maheen-ahmed1/OptoTACH/simulation/sweep_report.html

# Tachometer counting chain — 1 to 100 Hz sweep

Behavioural simulation of the circuit as built: 1.000 s gate from the 32.768 kHz chain, ÷60 burst multiplier, NE555 burst clock at 4800 Hz (R8 1k, R9 1k, C3 100nF). 12 input phases × 6 gate windows at every frequency.

Usable ceiling

4800 RPM

Quantisation

±60 RPM

Above ceiling

reads half

Timebase error

<0.005%

## What the display shows vs. actual speed

Dashed grey is a perfect instrument. Below 4800 RPM both traces sit on it.

As built — C3 = 100 nF C3 = 22 nF ideal instrument

The failure is silent. Past about 4900 RPM every second revolution arrives while the previous 12.5 ms burst is still running, so the latch ignores it. Exactly half the revolutions are dropped and the display settles on a steady, confident half reading — 6000 RPM shows as 3000. Nothing flickers or blanks to warn you.

## Worst-case error

At low speed both are limited by the same ±1 revolution quantisation; only the behaviour at the ceiling differs.

As built C3 = 22 nF

Data table

Input Hz | True RPM | Reads (as built) | Reads (22 nF) | Revs lost
1 | 60 | 60–60 | 60–60 | 0%
2 | 120 | 120–120 | 120–120 | 0%
5 | 300 | 300–300 | 300–300 | 0%
10 | 600 | 600–600 | 600–600 | 0%
20 | 1,200 | 1,200–1,200 | 1,200–1,200 | 0%
30 | 1,800 | 1,800–1,800 | 1,800–1,800 | 0%
40 | 2,400 | 2,400–2,400 | 2,400–2,400 | 0%
50 | 3,000 | 3,000–3,000 | 3,000–3,000 | 0%
60 | 3,600 | 3,600–3,600 | 3,600–3,600 | 0%
70 | 4,200 | 4,200–4,200 | 4,200–4,200 | 0%
75 | 4,500 | 4,500–4,500 | 4,500–4,500 | 0%
78 | 4,680 | 4,680–4,680 | 4,680–4,680 | 0%
80 | 4,800 | 3,840–4,800 | 4,800–4,800 | 6%
82 | 4,920 | 2,460–2,460 | 4,920–4,920 | 50%
85 | 5,100 | 2,524–2,576 | 5,100–5,100 | 50%
90 | 5,400 | 2,700–2,700 | 5,400–5,400 | 50%
95 | 5,700 | 2,830–2,870 | 5,700–5,700 | 50%
100 | 6,000 | 3,000–3,000 | 6,000–6,000 | 50%
