maheen-ahmed1/OptoTACH/media/optotach_display_powered.jpeg

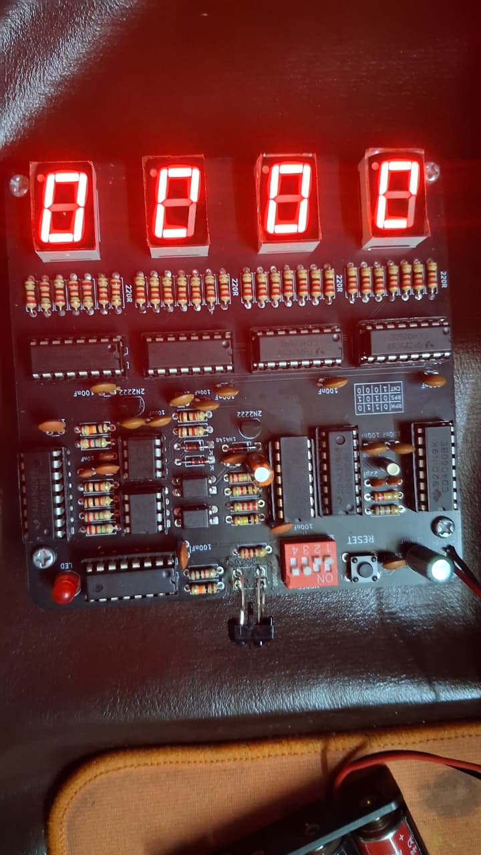
media/optotach_display_powered.jpeg
