maheen-ahmed1/OptoTACH/fabrication/BOM_OptoTACH_v1.0.csv

Refs | Value | Fit | Footprint | Qty | Source | Store | Notes
C1,C2,C7,C9,C12-C22 | 100nF | 100nF | Capacitor_THT:C_Disc_D3.0mm_W1.6mm_P2.50mm | 15 | Buy | RoboticsBD
C3 | 100nF | 100nF | Capacitor_THT:C_Disc_D3.0mm_W1.6mm_P2.50mm | 1 | Buy | RoboticsBD | NE555 (U6) burst oscillator - see alternate row below
C4,C5 | 22pF | 22pF | Capacitor_THT:C_Disc_D3.0mm_W1.6mm_P2.50mm | 2 | Buy | RoboticsBD
C6 | 1uF | 1uF | Capacitor_THT:C_Disc_D3.0mm_W1.6mm_P2.50mm | 1 | Buy | RoboticsBD | Ceramic, NOT electrolytic - this one sees both polarities
C8 | 100uF | 100uF | Capacitor_THT:CP_Radial_D6.3mm_P2.50mm | 1 | In stock
C10,C11 | 10nF | 10nF | Capacitor_THT:C_Disc_D3.0mm_W1.6mm_P2.50mm | 2 | Buy | Robotech, Techshop
D1-D3 | 1N4148 | 1N4148 | Diode_THT:D_DO-35_SOD27_P7.62mm_Horizontal | 3 | Buy | RoboticsBD
D4 | LED | LED | LED_THT:LED_D5.0mm | 1 | In stock
DS1-DS4 | 7SEG_CC_0.56in | 7SEG_CC_0.56in | Display_7Segment:7SegmentLED_LTS6760_LTS6780 | 4 | In stock |  | COMMON CATHODE. A common-anode part will not light at all.
J1 | PWR 5-6V | PWR 5-6V | Connector_PinHeader_2.54mm:PinHeader_1x02_P2.54mm_Vertical | 1 | Not fitted |  | Not fitted - power leads soldered straight into the J1 holes
Q1,Q2 | 2N2222 | 2N2222 | Package_TO_SOT_THT:TO-92_Inline | 2 | Buy | RoboticsBD | TO-92 plastic, not the TO-18 metal can
R1 | 200 | 220 | Resistor_THT:R_Axial_DIN0207_L6.3mm_D2.5mm_P7.62mm_Horizontal | 1 | Buy | Any shop | Drawn as 200, fit 220 - TCRT5000 IR LED current: 21.6 mA instead of 23.8 mA at 6 V
R2,R17 | 10K | 10K | Resistor_THT:R_Axial_DIN0207_L6.3mm_D2.5mm_P7.62mm_Horizontal | 2 | In stock
R3,R4,R7-R9,R14 | 1K | 1K | Resistor_THT:R_Axial_DIN0207_L6.3mm_D2.5mm_P7.62mm_Horizontal | 6 | In stock
R5,R6 | 2.2M | 2.2M | Resistor_THT:R_Axial_DIN0207_L6.3mm_D2.5mm_P7.62mm_Horizontal | 2 | In stock |  | Replaces the original design's 2M (not a stocked value)
R10 | 6.8K | 5.6K | Resistor_THT:R_Axial_DIN0207_L6.3mm_D2.5mm_P7.62mm_Horizontal | 1 | In stock |  | Drawn as 6.8K, fit 5.6K from stock - Q2 base resistor, only needs to saturate the transistor
R11 | 10M | 10M | Resistor_THT:R_Axial_DIN0207_L6.3mm_D2.5mm_P7.62mm_Horizontal | 1 | In stock
R12 | 220K | 220K | Resistor_THT:R_Axial_DIN0207_L6.3mm_D2.5mm_P7.62mm_Horizontal | 1 | In stock
R13 | 100K | 100K | Resistor_THT:R_Axial_DIN0207_L6.3mm_D2.5mm_P7.62mm_Horizontal | 1 | In stock
R15 | 2K | 2.2K | Resistor_THT:R_Axial_DIN0207_L6.3mm_D2.5mm_P7.62mm_Horizontal | 1 | In stock |  | Drawn as 2K, fit 2.2K from stock - Q1 base resistor, only needs to saturate the transistor
R16 | 20K | 22K | Resistor_THT:R_Axial_DIN0207_L6.3mm_D2.5mm_P7.62mm_Horizontal | 1 | In stock |  | Drawn as 20K, fit 22K from stock - Pulldown on the counter clock line, value not critical
R20-R26,R30-R36,R40-R46,R50-R56 | 220 | 220 | Resistor_THT:R_Axial_DIN0207_L6.3mm_D2.5mm_P7.62mm_Horizontal | 28 | Buy | Any shop | Segment resistors, 4 digits x 7
SW1 | MODE | MODE | Button_Switch_THT:SW_DIP_SPSTx04_Slide_9.78x12.34mm_W7.62mm_P2.54mm | 1 | Buy | RoboticsBD
SW2 | RESET | RESET | Button_Switch_THT:SW_PUSH_6mm | 1 | In stock
U1 | TCRT5000 | TCRT5000 | tach_fp:TCRT5000_NoClip | 1 | In stock
U2 | CD4093 | CD4093 | Package_DIP:DIP-14_W7.62mm_LongPads | 1 | Buy | ElectronicsBD
U3,U5 | PC817 | PC817 | Package_DIP:DIP-4_W7.62mm_LongPads | 2 | Buy | RoboticsBD
U4,U6 | NE555P | NE555P | Package_DIP:DIP-8_W7.62mm_LongPads | 2 | Buy | RoboticsBD
U7,U8 | CD4017 | CD4017 | Package_DIP:DIP-16_W7.62mm_LongPads | 2 | Buy | RoboticsBD
U9,U10 | CD4060 | CD4060 | Package_DIP:DIP-16_W7.62mm_LongPads | 2 | Buy | RoboticsBD
U11-U14 | CD4026 | CD4026 | Package_DIP:DIP-16_W7.62mm_LongPads | 4 | Buy | RoboticsBD
Y1 | 32.768kHz | 32.768kHz | Crystal:Crystal_C38-LF_D3.0mm_L8.0mm_Vertical | 1 | Buy | Techshop
C3 (alt) | 22nF | 22nF | Capacitor_THT:C_Disc_D3.0mm_W1.6mm_P2.50mm | 1 | Buy | RoboticsBD | Fit INSTEAD of the 100nF to raise the RPM ceiling from ~4800 to ~21800. Buy both and compare.
