maheen-ahmed1/OptoTACH/fabrication/tach_v1.0_fitted_parts.pdf

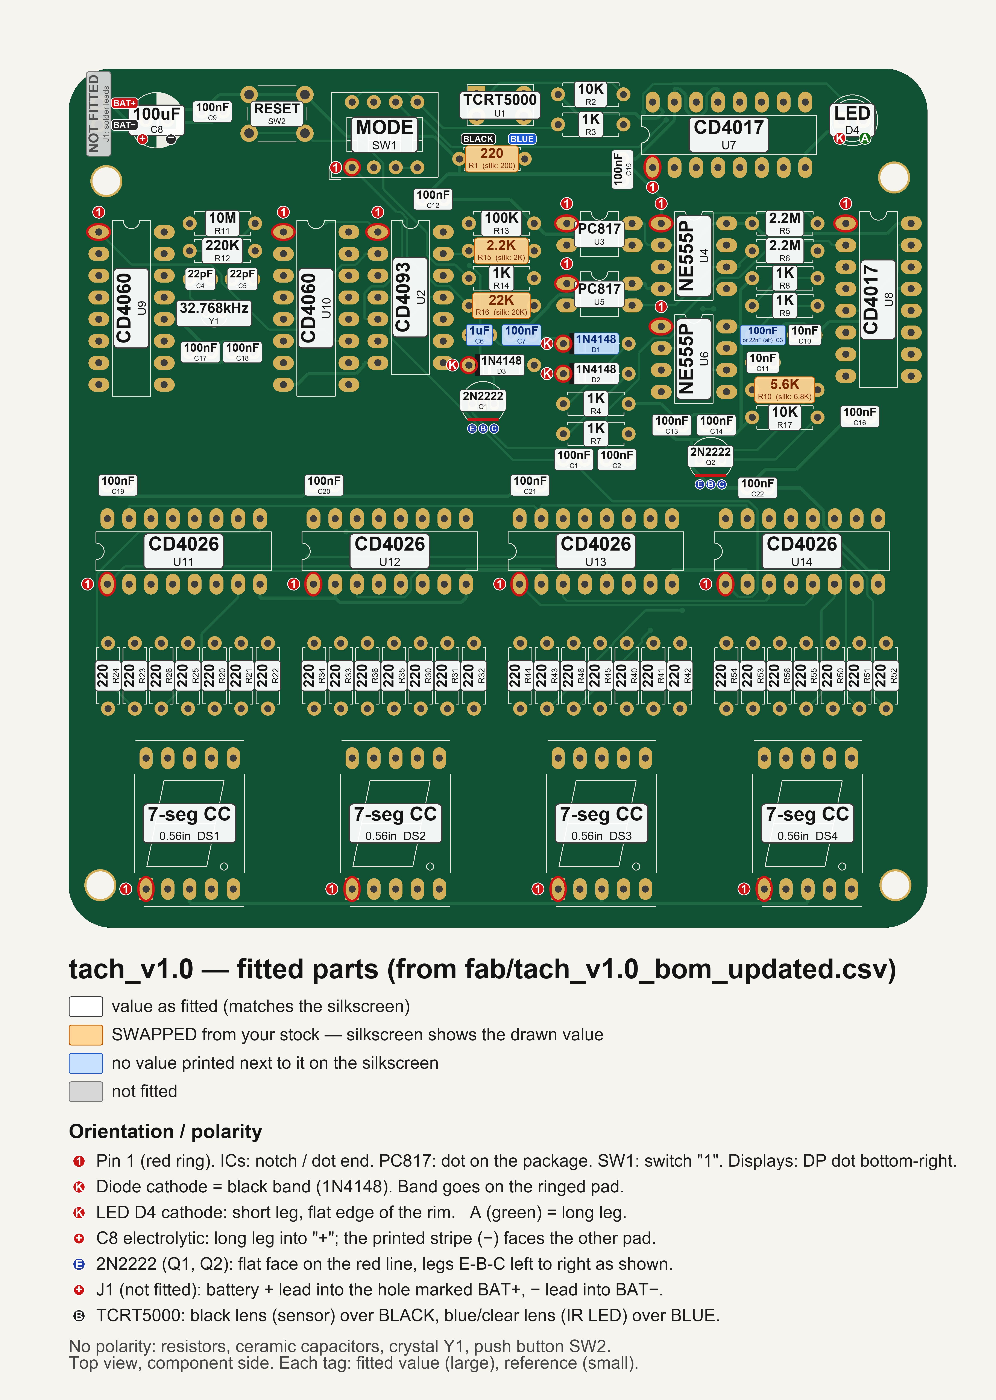
[picture p32: page 1]
