maheen-ahmed1/OptoTACH/fabrication/tach_v1.0_schematic.pdf

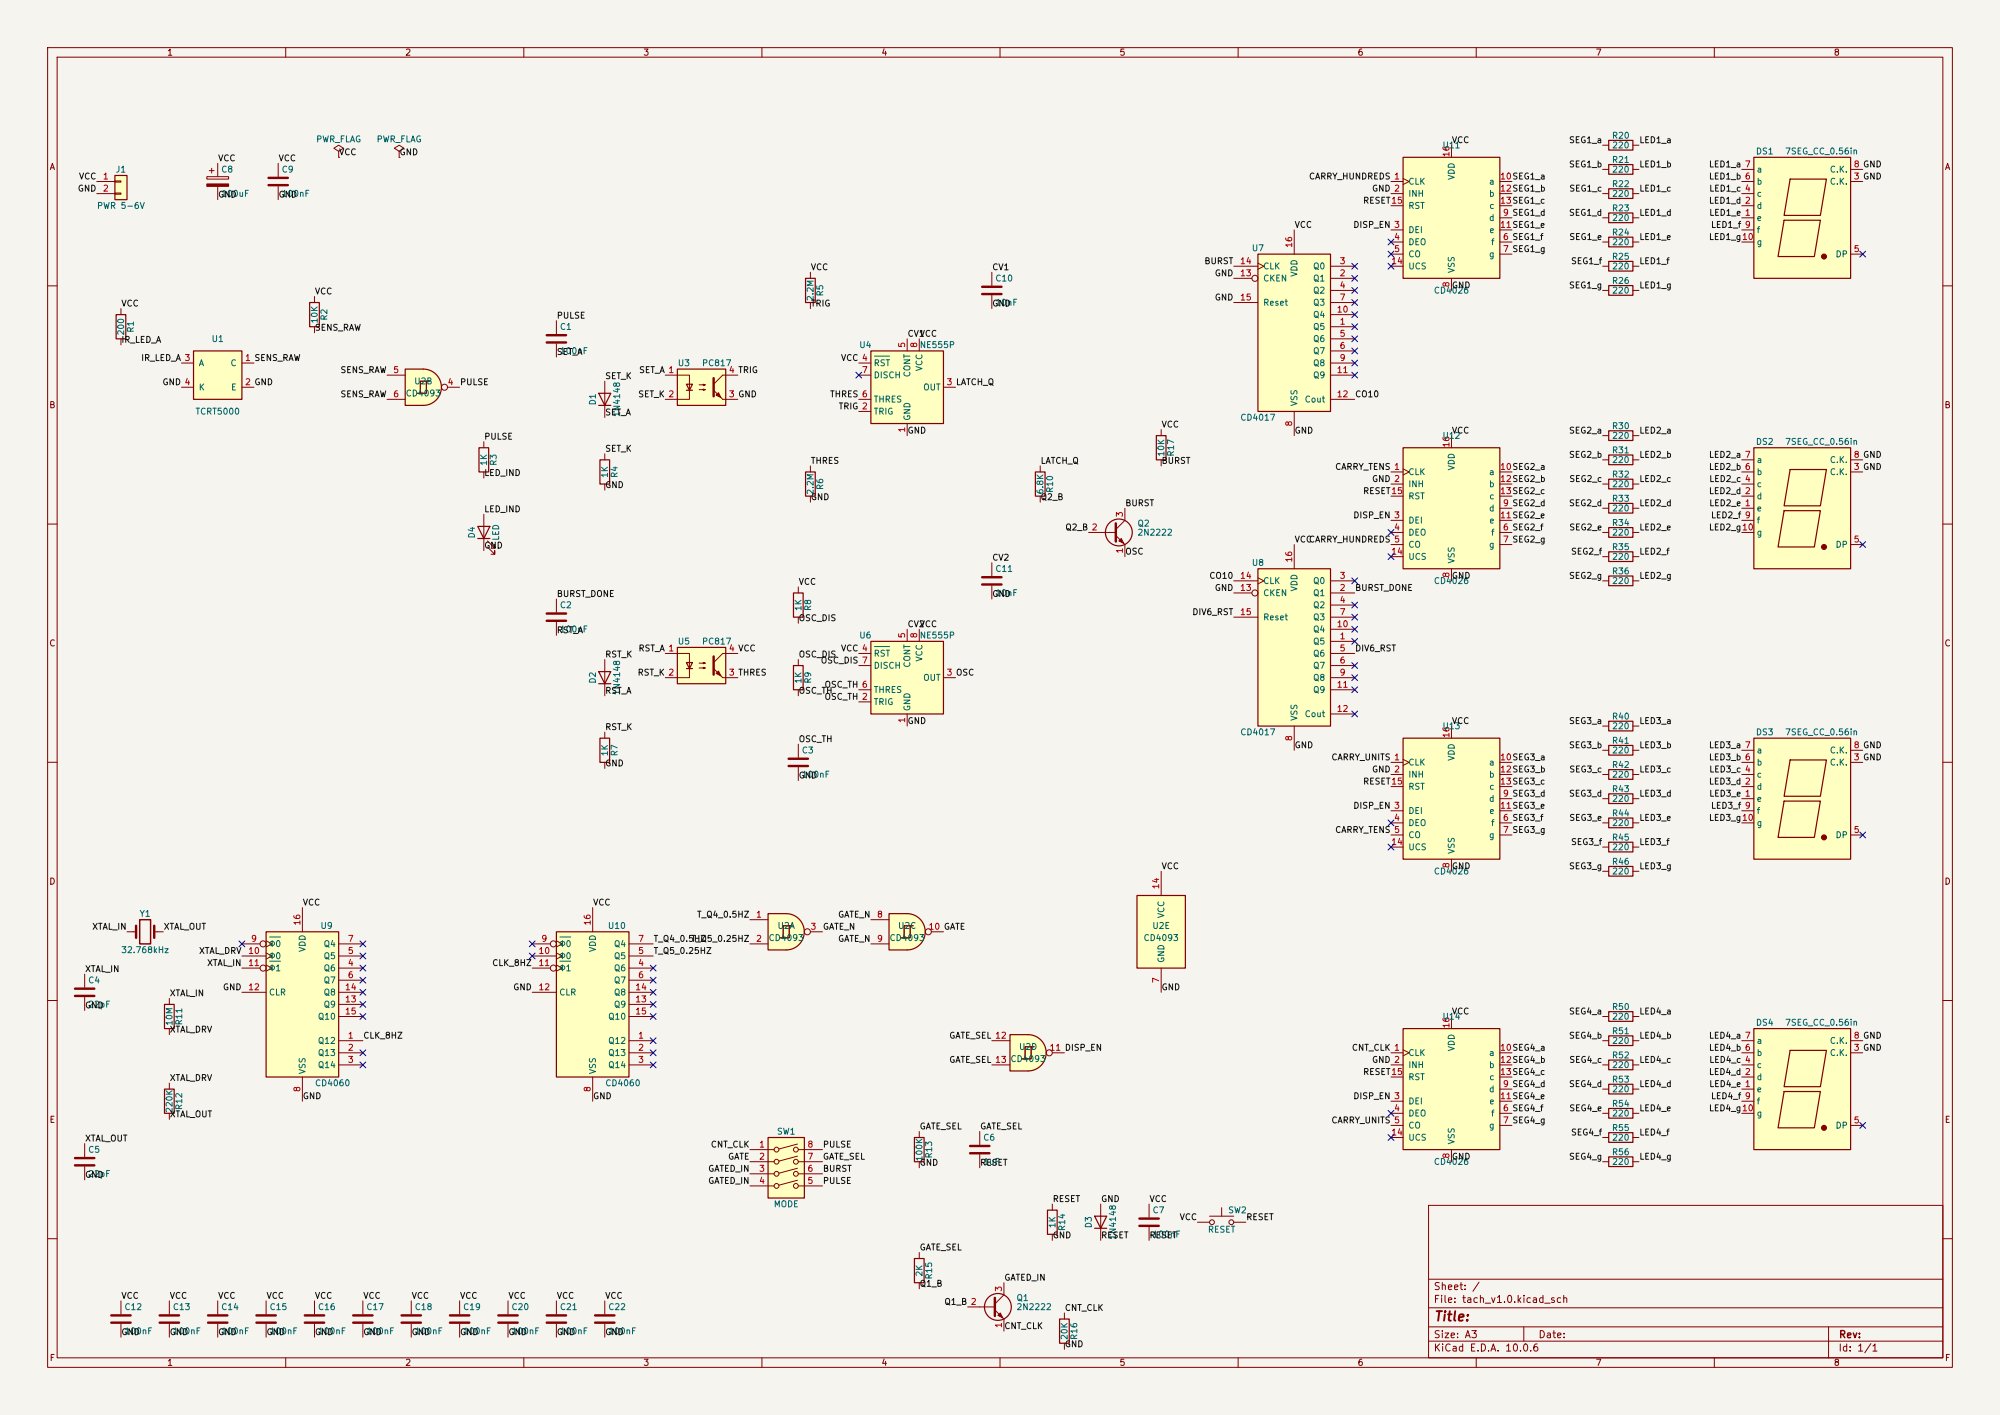
[picture p33: page 1]

8 Q8 9 Q4 10 Q9 11 Cout 12 CKEN 13 CLK 14 Reset 15 VDD 16 U7 CD4017

8 Q8 9 Q4 10 Q9 11 Cout 12 CKEN 13 CLK 14 Reset 15 VDD 16 U8 CD4017

Size: A3 | Rev: | F Date:
KiCad E.D.A. 10.0.6 | Id: 1/1
