maheen-ahmed1/OptoTACH/fabrication/tach_v1.0_assembly.pdf

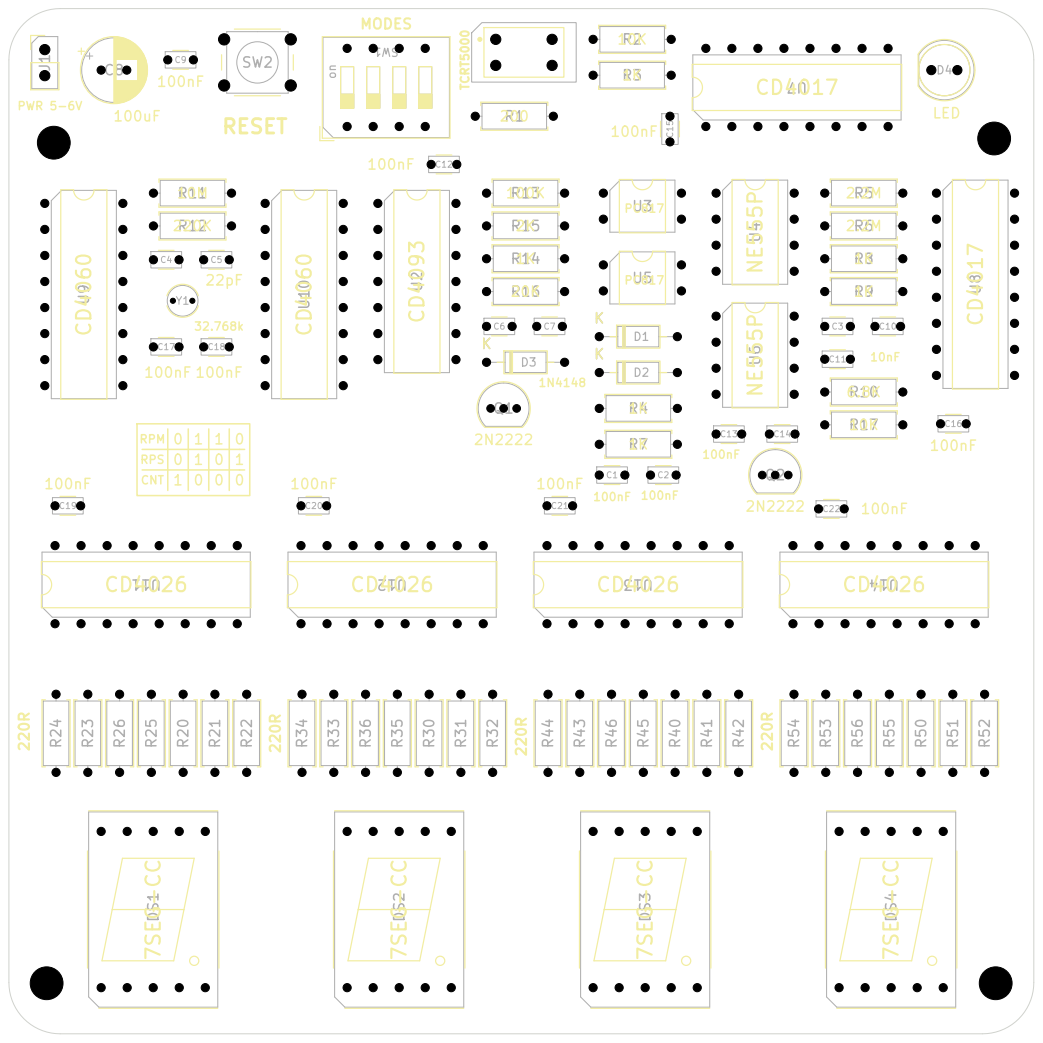
[picture p34: page 1]
