maheen-ahmed1/OptoTACH/hardware/tach_v1.0.kicad_pcb

## KiCad design hardware/tach_v1.0.kicad_pcb (2026-10-22)

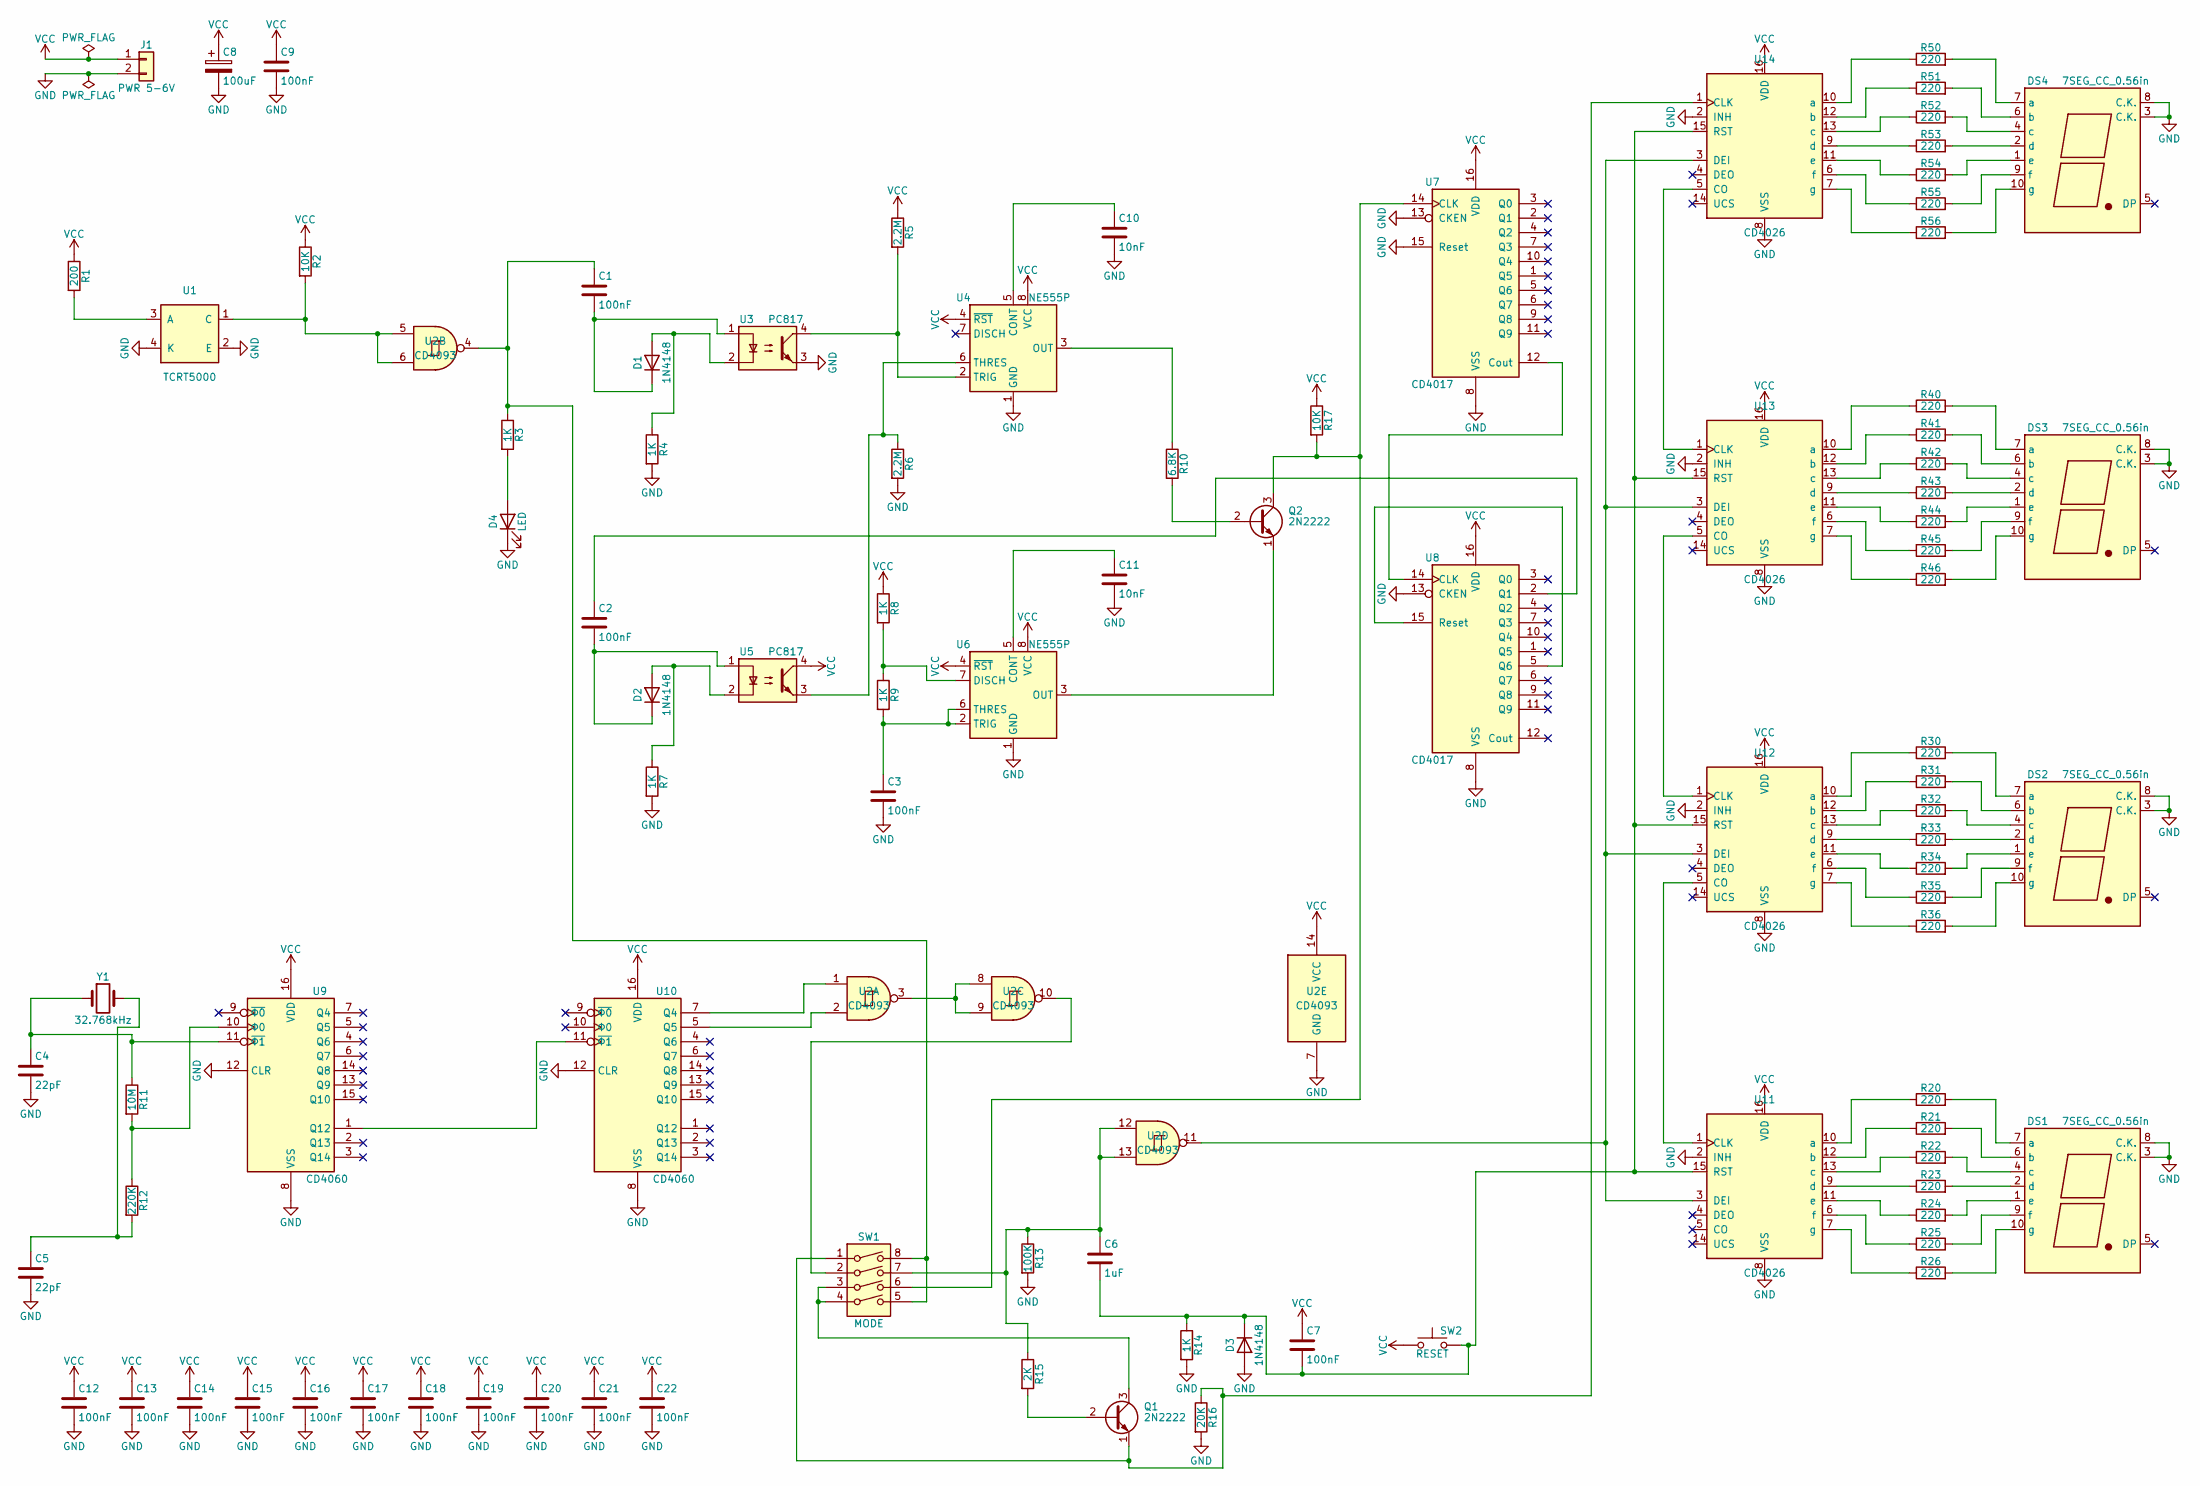
[picture p35: schematic tach_v1.0.kicad_sch]

Parts:
C1, C2, C3, C7, C9, C12, C13, C14, C15, C16, C17, C18, C19, C20, C21, C22: 100nF; C_Disc_D3.0mm_W1.6mm_P2.50mm
C4, C5: 22pF; C_Disc_D3.0mm_W1.6mm_P2.50mm
C6: 1uF; C_Disc_D3.0mm_W1.6mm_P2.50mm
C8: 100uF; CP_Radial_D6.3mm_P2.50mm
C10, C11: 10nF; C_Disc_D3.0mm_W1.6mm_P2.50mm
D1, D2, D3: 1N4148; D_DO-35_SOD27_P7.62mm_Horizontal
D4: LED; LED_D5.0mm
DS1, DS2, DS3, DS4: 7SEG_CC_0.56in; 7SegmentLED_LTS6760_LTS6780
J1: PWR 5-6V; PinHeader_1x02_P2.54mm_Vertical
Q1, Q2: 2N2222; TO-92_Inline
R1: 200; R_Axial_DIN0207_L6.3mm_D2.5mm_P7.62mm_Horizontal
R2, R17: 10K; R_Axial_DIN0207_L6.3mm_D2.5mm_P7.62mm_Horizontal
R3, R4, R7, R8, R9, R14: 1K; R_Axial_DIN0207_L6.3mm_D2.5mm_P7.62mm_Horizontal
R5, R6: 2.2M; R_Axial_DIN0207_L6.3mm_D2.5mm_P7.62mm_Horizontal
R10: 6.8K; R_Axial_DIN0207_L6.3mm_D2.5mm_P7.62mm_Horizontal
R11: 10M; R_Axial_DIN0207_L6.3mm_D2.5mm_P7.62mm_Horizontal
R12: 220K; R_Axial_DIN0207_L6.3mm_D2.5mm_P7.62mm_Horizontal
R13: 100K; R_Axial_DIN0207_L6.3mm_D2.5mm_P7.62mm_Horizontal
R15: 2K; R_Axial_DIN0207_L6.3mm_D2.5mm_P7.62mm_Horizontal
R16: 20K; R_Axial_DIN0207_L6.3mm_D2.5mm_P7.62mm_Horizontal
R20, R21, R22, R23, R24, R25, R26, R30, R31, R32, R33, R34, R35, R36, R40, R41, R42, R43, R44, R45, R46, R50, R51, R52, R53, R54, R55, R56: 220; R_Axial_DIN0207_L6.3mm_D2.5mm_P7.62mm_Horizontal
SW1: MODE; SW_DIP_SPSTx04_Slide_9.78x12.34mm_W7.62mm_P2.54mm
SW2: RESET; SW_PUSH_6mm
U1: TCRT5000; TCRT5000_NoClip
U2: CD4093; DIP-14_W7.62mm_LongPads
U3, U5: PC817; DIP-4_W7.62mm_LongPads
U4, U6: NE555P; DIP-8_W7.62mm_LongPads
U7, U8: CD4017; DIP-16_W7.62mm_LongPads
U9, U10: CD4060; DIP-16_W7.62mm_LongPads
U11, U12, U13, U14: CD4026; DIP-16_W7.62mm_LongPads
Y1: 32.768kHz; Crystal_C38-LF_D3.0mm_L8.0mm_Vertical

Connections:
/BURST: Q2.3 (C), R17.2, SW1.6, U7.14 (CLK)
/BURST_DONE: C2.1, U8.2 (Q1)
/CARRY_HUNDREDS: U11.1 (CLK), U12.5 (CO)
/CARRY_TENS: U12.1 (CLK), U13.5 (CO)
/CARRY_UNITS: U13.1 (CLK), U14.5 (CO)
/CLK_8HZ: U9.1 (Q12), U10.11 (~Φ1)
/CNT_CLK: Q1.1 (E), R16.1, SW1.1, U14.1 (CLK)
/CO10: U7.12 (Cout), U8.14 (CLK)
/CV1: C10.1, U4.5 (CONT)
/CV2: C11.1, U6.5 (CONT)
/DISP_EN: U2.11, U11.3 (DEI), U12.3 (DEI), U13.3 (DEI), U14.3 (DEI)
/DIV6_RST: U8.5 (Q6), U8.15 (Reset)
/GATE: SW1.2, U2.10
/GATED_IN: Q1.3 (C), SW1.3, SW1.4
/GATE_N: U2.3, U2.8, U2.9
/GATE_SEL: C6.1, R13.1, R15.1, SW1.7, U2.12, U2.13
/GND: C3.2, C4.2, C5.2, C8.2, C9.2, C10.2, C11.2, C12.2, C13.2, C14.2, C15.2, C16.2, C17.2, C18.2, C19.2, C20.2, C21.2, C22.2, D3.2 (A), D4.1 (K), DS1.3 (C.K.), DS1.8 (C.K.), DS2.3 (C.K.), DS2.8 (C.K.), DS3.3 (C.K.), DS3.8 (C.K.), DS4.3 (C.K.), DS4.8 (C.K.), J1.2, R4.2, R6.2, R7.2, R13.2, R14.2, R16.2, U1.2 (E), U1.4 (K), U2.7 (GND), U3.3, U4.1 (GND), U6.1 (GND), U7.8 (VSS), U7.13 (CKEN), U7.15 (Reset), U8.8 (VSS), U8.13 (CKEN), U9.8 (VSS), U9.12 (CLR), U10.8 (VSS), U10.12 (CLR), U11.2 (INH), U11.8 (VSS), U12.2 (INH), U12.8 (VSS), U13.2 (INH), U13.8 (VSS), U14.2 (INH), U14.8 (VSS)
/IR_LED_A: R1.2, U1.3 (A)
/LATCH_Q: R10.1, U4.3 (OUT)
/LED1_a: DS1.7 (a), R20.2
/LED1_b: DS1.6 (b), R21.2
/LED1_c: DS1.4 (c), R22.2
/LED1_d: DS1.2 (d), R23.2
/LED1_e: DS1.1 (e), R24.2
/LED1_f: DS1.9 (f), R25.2
/LED1_g: DS1.10 (g), R26.2
/LED2_a: DS2.7 (a), R30.2
/LED2_b: DS2.6 (b), R31.2
/LED2_c: DS2.4 (c), R32.2
/LED2_d: DS2.2 (d), R33.2
/LED2_e: DS2.1 (e), R34.2
/LED2_f: DS2.9 (f), R35.2
/LED2_g: DS2.10 (g), R36.2
/LED3_a: DS3.7 (a), R40.2
/LED3_b: DS3.6 (b), R41.2
/LED3_c: DS3.4 (c), R42.2
/LED3_d: DS3.2 (d), R43.2
/LED3_e: DS3.1 (e), R44.2
/LED3_f: DS3.9 (f), R45.2
/LED3_g: DS3.10 (g), R46.2
/LED4_a: DS4.7 (a), R50.2
/LED4_b: DS4.6 (b), R51.2
/LED4_c: DS4.4 (c), R52.2
/LED4_d: DS4.2 (d), R53.2
/LED4_e: DS4.1 (e), R54.2
/LED4_f: DS4.9 (f), R55.2
/LED4_g: DS4.10 (g), R56.2
/LED_IND: D4.2 (A), R3.2
/OSC: Q2.1 (E), U6.3 (OUT)
/OSC_DIS: R8.2, R9.1, U6.7 (DISCH)
/OSC_TH: C3.1, R9.2, U6.2 (TRIG), U6.6 (THRES)
/PULSE: C1.1, R3.1, SW1.5, SW1.8, U2.4
/Q1_B: Q1.2 (B), R15.2
/Q2_B: Q2.2 (B), R10.2
/RESET: C6.2, C7.2, D3.1 (K), R14.1, SW2.2, U11.15 (RST), U12.15 (RST), U13.15 (RST), U14.15 (RST)
/RST_A: C2.2, D2.1 (K), U5.1
/RST_K: D2.2 (A), R7.1, U5.2
/SEG1_a: R20.1, U11.10 (a)
/SEG1_b: R21.1, U11.12 (b)
/SEG1_c: R22.1, U11.13 (c)
/SEG1_d: R23.1, U11.9 (d)
/SEG1_e: R24.1, U11.11 (e)
/SEG1_f: R25.1, U11.6 (f)
/SEG1_g: R26.1, U11.7 (g)
/SEG2_a: R30.1, U12.10 (a)
/SEG2_b: R31.1, U12.12 (b)
/SEG2_c: R32.1, U12.13 (c)
/SEG2_d: R33.1, U12.9 (d)
/SEG2_e: R34.1, U12.11 (e)
/SEG2_f: R35.1, U12.6 (f)
/SEG2_g: R36.1, U12.7 (g)
/SEG3_a: R40.1, U13.10 (a)
/SEG3_b: R41.1, U13.12 (b)
/SEG3_c: R42.1, U13.13 (c)
/SEG3_d: R43.1, U13.9 (d)
/SEG3_e: R44.1, U13.11 (e)
/SEG3_f: R45.1, U13.6 (f)
/SEG3_g: R46.1, U13.7 (g)
/SEG4_a: R50.1, U14.10 (a)
/SEG4_b: R51.1, U14.12 (b)
/SEG4_c: R52.1, U14.13 (c)
/SEG4_d: R53.1, U14.9 (d)
/SEG4_e: R54.1, U14.11 (e)
/SEG4_f: R55.1, U14.6 (f)
/SEG4_g: R56.1, U14.7 (g)
/SENS_RAW: R2.2, U1.1 (C), U2.5, U2.6
/SET_A: C1.2, D1.1 (K), U3.1
/SET_K: D1.2 (A), R4.1, U3.2
/THRES: R6.1, U4.6 (THRES), U5.3
/TRIG: R5.2, U3.4, U4.2 (TRIG)
/T_Q4_0.5HZ: U2.1, U10.7 (Q4)
/T_Q5_0.25HZ: U2.2, U10.5 (Q5)
/VCC: C7.1, C8.1, C9.1, C12.1, C13.1, C14.1, C15.1, C16.1, C17.1, C18.1, C19.1, C20.1, C21.1, C22.1, J1.1, R1.1, R2.1, R5.1, R8.1, R17.1, SW2.1, U2.14 (VCC), U4.4 (~RST), U4.8 (VCC), U5.4, U6.4 (~RST), U6.8 (VCC), U7.16 (VDD), U8.16 (VDD), U9.16 (VDD), U10.16 (VDD), U11.16 (VDD), U12.16 (VDD), U13.16 (VDD), U14.16 (VDD)
/XTAL_DRV: R11.2, R12.1, U9.10 (Φ0)
/XTAL_IN: C4.1, R11.1, U9.11 (~Φ1), Y1.1
/XTAL_OUT: C5.1, R12.2, Y1.2

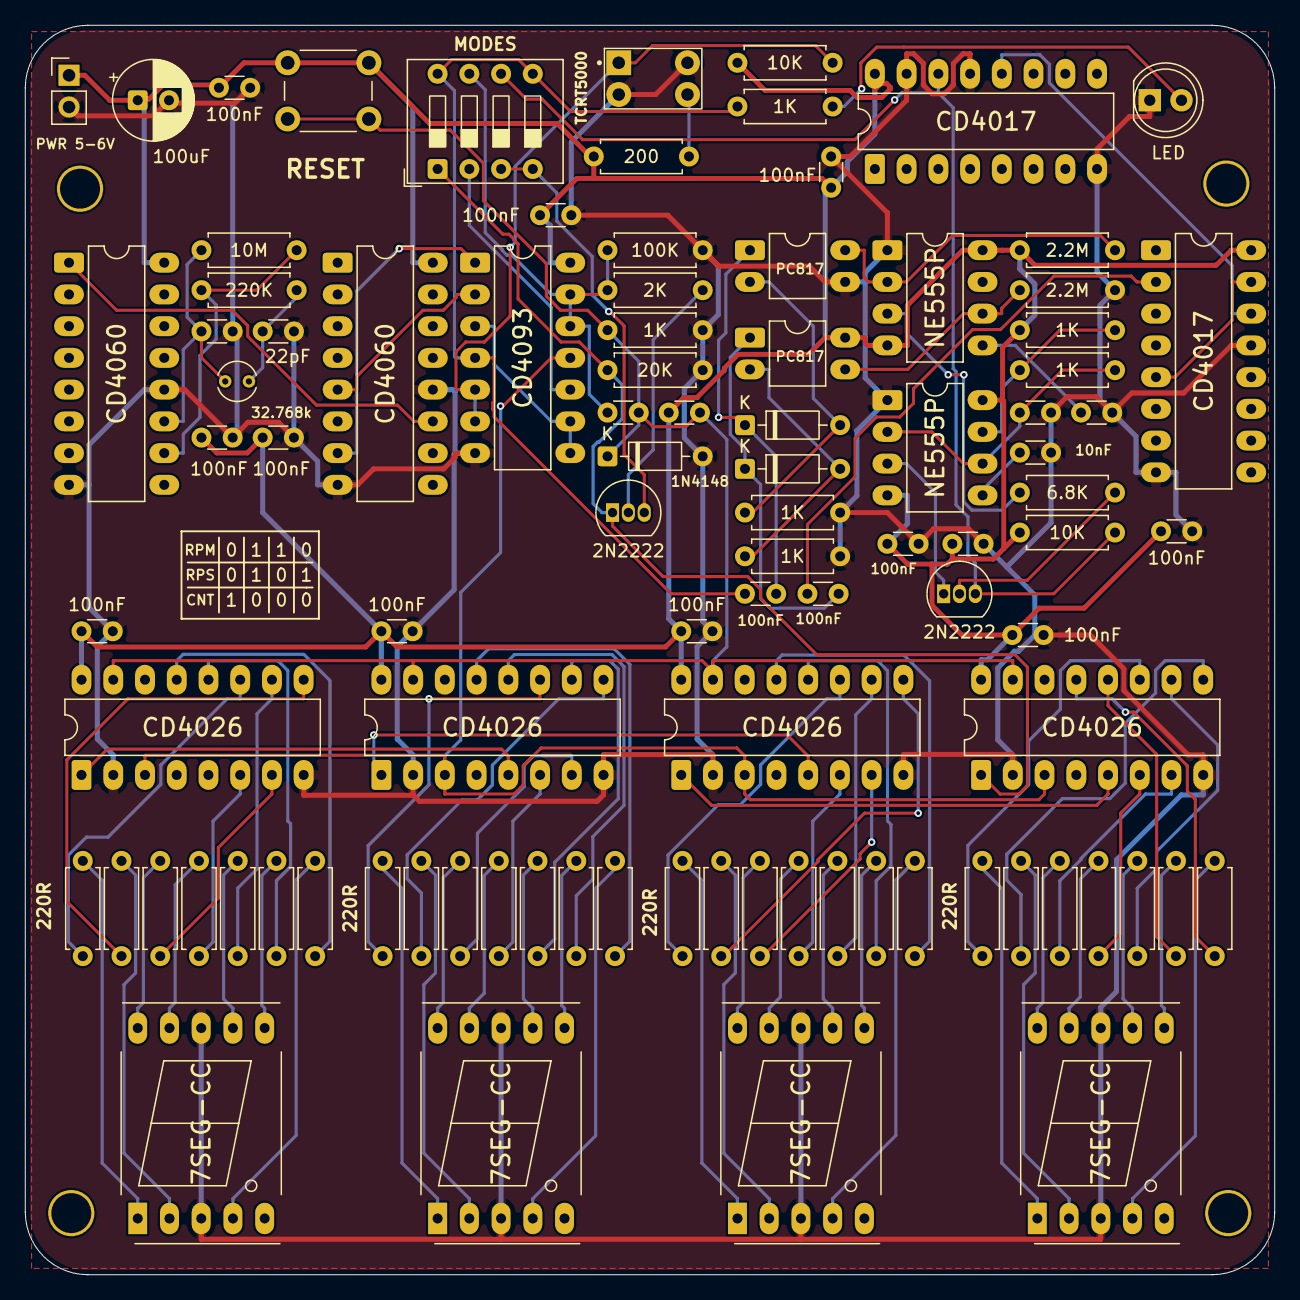
[picture p36: board tach_v1.0.kicad_pcb from above]

Board: 2 copper layers, 100.0 x 100.0 mm, 99 parts (0 on the bottom side), 96 nets.

Other parts of the board:
H1, H2, H3, H4: MountingHole; MountingHole_3.2mm
